TrueKillRob/LiPo-Akku-Switch/hardware/Schematics.png

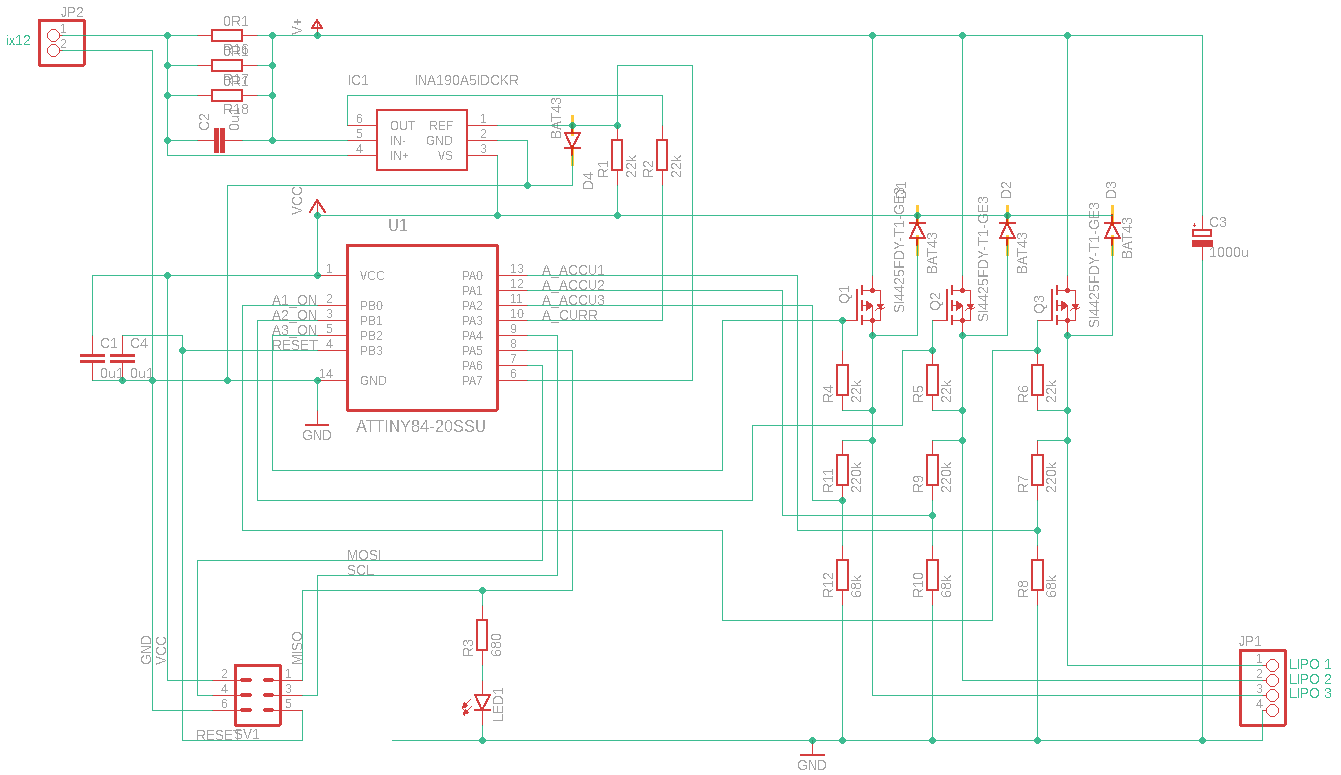
hardware/Schematics.png
