TrueKillRob/LiPo-Akku-Switch/hardware/BOM.xlsx

Qty | Value | Device | Package | Parts | Description | DESCRIPTION2 | HEIGHT | MANUFACTURER_NAME | MANUFACTURER_PART_NUMBER | MF | MOUSER_PART_NUMBER | MOUSER_PRICE-STOCK | MPN | OC_FARNELL | OC_NEWARK | PACKAGE3 | POPULARITY | SPICEPREFIX | SUPPLIER
1 |  | LED3MM | LED3MM | LED1 | LED |  |  |  |  |  |  |  |  |  |  |  | 97
1 |  | ML6 | ML6 | SV1 | HARTING |  |  |  |  |  |  |  |  | unknown | unknown |  | 5
1 |  | PINHD-1X2 | 1X02 | JP2 | PIN HEADER |  |  |  |  |  |  |  |  |  |  |  | 98
1 |  | PINHD-1X4 | 1X04 | JP1 | PIN HEADER |  |  |  |  |  |  |  |  |  |  |  | 91
3 | 0R1 | R-EU_R0805 | R0805 | R16, R17, R18 | RESISTOR, European symbol |  |  |  |  |  |  |  |  |  |  |  | 86 | R
3 | 0u1 | C-EUC0805K | C0805K | C1, C2, C4 | CAPACITOR, European symbol |  |  |  |  |  |  |  |  |  |  |  | 52 | C
1 | 1000u | CPOL-EU153CLV-1010 | 153CLV-1010 | C3 | POLARIZED CAPACITOR, European symbol |  |  |  |  |  |  |  |  |  |  |  | 0 | C
3 | 220k | R-EU_R0805 | R0805 | R7, R9, R11 | RESISTOR, European symbol |  |  |  |  |  |  |  |  |  |  |  | 86 | R
5 | 22k | R-EU_R0805 | R0805 | R1, R2, R4, R5, R6 | RESISTOR, European symbol |  |  |  |  |  |  |  |  |  |  |  | 86 | R
1 | 680 | R-EU_R0805 | R0805 | R3 | RESISTOR, European symbol |  |  |  |  |  |  |  |  |  |  |  | 86 | R
3 | 68k | R-EU_R0805 | R0805 | R8, R10, R12 | RESISTOR, European symbol |  |  |  |  |  |  |  |  |  |  |  | 86 | R
1 | ATTINY84-20SSU | ATTINY84-20SSU | SOIC127P600X175-14N | U1 | 8-bit Microcontroller with Bytes In-System Programmable Flash |  |  |  |  |  |  |  | ATTINY84-20SSU | 1636955 | 03P2040 | SOIC-14 |  |  | Atmel
4 | BAT43 | DIODE-MINIMELF | MINIMELF | D1, D2, D3, D4 | DIODE |  |  |  |  |  |  |  |  |  |  |  | 25
1 | INA190A5IDCKR | INA190A5IDCKR | SOT65P210X110-6N | IC1 | 40V, bi-directional, low-/high-side, zero-drift, voltage output CSA w/low bias current and enable | 40V, bi-directional, low-/high-side, zero-drift, voltage output CSA w/low bias current and enable | 1.1mm | Texas Instruments | INA190A5IDCKR |  | 595-INA190A5IDCKR | https://www.mouser.co.uk/ProductDetail/Texas-Instruments/INA190A5IDCKR?qs=EBDBlbfErPxv%2F6Q8eRJOoA%3D%3D
3 | SI4425FDY-T1-GE3 | BSO201SP | SO-8 | Q1, Q2, Q3 | OptiMOS(R)-P Small-Signal-Transistor P-Channel, Enhancement mode, Super Logic Level (2.5 V rated) |  |  |  |  |  |  |  |  |  |  |  | 6
