TrueKillRob/LiPo-Akku-Switch/(commit log)

2021-12-13 Manual tested
    Added charging detection and enable charging for matching cells depending on there voltage
    Tested current detection with poti
2022-01-14 Productive running version
    After plugin it takes 45 sec to measure accu voltage. After that, output goes online.
    LED in on when charging is detected by current-direction-sensor.
